jonathanmolla/bluetooth-headphones/firmware/README.md

# STM32 controller configuration

[Firmware.ioc](Firmware.ioc) captures the STM32CubeMX configuration for the **STM32U031C8T6** headphone controller.

## Explore the configuration

1. Open `Firmware.ioc` in STM32CubeMX.
2. Inspect the controller pin assignments and configured peripherals.
3. Cross-reference the [MCU and button schematic](../hardware/main/MCU_Buttons.kicad_sch) to follow the hardware connections.

## Related design files

- [Controller schematic preview](../docs/schematics/main/Bluetooth%20Headphones%20Project-MCU_and_Buttons.svg)
- [Main audio board project](../hardware/main/)
- [System architecture](../docs/design.md)
