jonathanmolla/bluetooth-headphones/docs/schematics/README.md

# Circuit diagrams

Browser-readable schematic exports from KiCad 10.0.3.

| Diagram | Circuit contents | Editable source |
| --- | --- | --- |
| [Main project hierarchy](main/Bluetooth%20Headphones%20Project.svg) | Audio and controller sheet organization | [Root schematic](../../hardware/main/Bluetooth%20Headphones%20Project.kicad_sch) |
| [Bluetooth and audio](main/Bluetooth%20Headphones%20Project-Bluetooth_and_Audio.svg) | BM83 module, coupling capacitors and headphone amplifier | [Audio schematic](../../hardware/main/Bluetooth_Audio.kicad_sch) |
| [MCU and buttons](main/Bluetooth%20Headphones%20Project-MCU_and_Buttons.svg) | STM32 controller and button connections | [Controller schematic](../../hardware/main/MCU_Buttons.kicad_sch) |
| [Charging and power](power/Charging%20and%20Power.svg) | USB input, battery charging and regulation | [Power schematic](../../hardware/power/Charging%20and%20Power.kicad_sch) |

Open or download an SVG to zoom into the circuit. [PCB layouts and project files](../../hardware/) are organized by board.
