jonathanmolla/bluetooth-headphones/hardware/power/README.md

# Charging and power board

This board contains the USB power input, MCP73833 battery-charging circuit, and TPS7A2030PDBVR 3.0 V regulator.

## Charging and power PCB

**Editable board layout:** [Charging and Power.kicad_pcb](Charging%20and%20Power.kicad_pcb)

**Open the complete KiCad project:** [Charging and Power.kicad_pro](Charging%20and%20Power.kicad_pro)

**View the layout in your browser:** [Charging and power PCB preview](../../docs/images/power-board.svg)

## Schematic and component list

| File | Contents |
| --- | --- |
| [Power schematic](Charging%20and%20Power.kicad_sch) | Charging, regulation, indicators and board connections |
| [Component list](bom.csv) | Schematic references, values, footprints and datasheet links |

[View the power schematic](../../docs/schematics/power/Charging%20and%20Power.svg) · [Open the main audio board](../main/)

## Library files

`MCP73833-AMI_UN.pretty/` and `TPS7A2030PDBVR.pretty/` contain the local charger and regulator CAD assets. Keep these folders and both library tables beside the project when downloading it.
