jonathanmolla/bluetooth-headphones/docs/references.md

# Component documentation and references

| Component or tool | Documentation |
| --- | --- |
| BM83 Bluetooth audio module | [Microchip product page](https://www.microchip.com/en-us/product/BM83) |
| TPA6130A2 headphone amplifier | [TI datasheet](https://www.ti.com/lit/ds/symlink/tpa6130a2.pdf) |
| STM32U031 controller | [ST datasheet](https://www.st.com/resource/en/datasheet/stm32u031r6.pdf) |
| TPS7A20 regulator | [TI documentation](https://www.ti.com/lit/gpn/TPS7A20) |
| MCP73833 charger | [Microchip datasheet](https://ww1.microchip.com/downloads/aemDocuments/documents/APID/ProductDocuments/DataSheets/MCP73833-4-Stand-Alone-Linear-Li-Ion-Li-Polymer-Charge-Management-Control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) |
| KiCad | [Tool documentation](https://docs.kicad.org/) |

## CAD and simulation assets

Project-local symbols and footprints accompany the native design files. Third-party CAD assets and standard library material retain their respective authorship and terms. Manufacturer documentation is accessible through the links above.

The LTspice library contains educational ideal-source and differential-gain models. Its [parameter definitions and analysis instructions](../simulation/README.md) document the analog-network representation used in this project.
