jonathanmolla/bluetooth-headphones/hardware/power/bom.csv

Reference | Value | Footprint | Datasheet | Source
C1 | 1uF | Capacitor_SMD:C_0805_2012Metric |  | KiCad schematic
C2 | 1uF | Capacitor_SMD:C_0805_2012Metric |  | KiCad schematic
C3 | 1uF | Capacitor_SMD:C_0805_2012Metric |  | KiCad schematic
C4 | 1uF | Capacitor_SMD:C_0805_2012Metric |  | KiCad schematic
D1 | LED Yellow | LED_SMD:LED_0805_2012Metric |  | KiCad schematic
D2 | LED Green | LED_SMD:LED_0805_2012Metric |  | KiCad schematic
D3 | LED Red | LED_SMD:LED_0805_2012Metric |  | KiCad schematic
J2 | Battery rail | Connector_JST:JST_PH_B2B-PH-K_1x02_P2.00mm_Vertical |  | KiCad schematic
J3 | USB-C 5V IN | Connector_USB:USB_C_Receptacle_GCT_USB4125-xx-x_6P_TopMnt_Horizontal |  | KiCad schematic
J6 | To Main PCB | Connector_JST:JST_PH_B3B-PH-K_1x03_P2.00mm_Vertical |  | KiCad schematic
R1 | 470 | Resistor_SMD:R_0805_2012Metric |  | KiCad schematic
R2 | 470 | Resistor_SMD:R_0805_2012Metric |  | KiCad schematic
R3 | 470 | Resistor_SMD:R_0805_2012Metric |  | KiCad schematic
R4 | 12.7k | Resistor_SMD:R_0603_1608Metric |  | KiCad schematic
R8 | 5.1k | Resistor_SMD:R_0805_2012Metric |  | KiCad schematic
R9 | 5.1k | Resistor_SMD:R_0805_2012Metric |  | KiCad schematic
TH1 | 10k NTC | Connector_Wire:SolderWire-0.1sqmm_1x02_P3.6mm_D0.4mm_OD1mm |  | KiCad schematic
U1 | TPS7A2030PDBVR | TPS7A2030PDBVR:SOT95P280X145-5N |  | KiCad schematic
U2 | MCP73833-AMI_UN | MCP73833-AMI_UN:SOP50P490X110-10N |  | KiCad schematic
