jonathanmolla/bluetooth-headphones/simulation/Headphones_Audio.asc

C_BYPASS: cap; 1µ
C_L: cap; 0.47µ
C_LREF: cap; 0.47µ
C_R: cap; 0.47µ
C_RREF: cap; 0.47µ
R_LEFT_DRIVER: res; 38
R_RIGHT_DRIVER: res; 38
U_AMP: TPA6130A2_AUDIO_APPROX
U_BM83: BM83_AUDIO_APPROX
V_BATTERY: voltage; {VBAT}
Named nets: 0, AMP_INML, AMP_INMR, HPLEFT, HPRIGHT, VBAT
Bluetooth headphones - stereo analog audio path
Simplified models only: BM83 DAC sources -> coupling -> amplifier -> resistive drivers
Educational approximation - see README.md for analysis instructions
.include audio_models.lib
.param VBAT=3.7 VBIAS=1.35 VSIG=50m FTEST=1k AVOL=1 RINPUT=37k
.ac dec 100 10 100k
Optional transient command (inactive): .tran 0 20m 0 1u
Bias 1.35 V and 50 mV signal are illustrative; 38 ohm loads approximate the drivers.
AVOL=1 is an ideal unity-gain setting; RINPUT=37k is a conservative input-resistance approximation.
Analysis scope: analog coupling-network response and ideal stereo voltage gain.
VBAT and supply bypassing identify the circuit supply reference.
.tran 5
