jonathanmolla/bluetooth-headphones/hardware/power/Charging and Power.kicad_pcb

## KiCad design hardware/power/Charging and Power.kicad_pcb (2026-11-12)

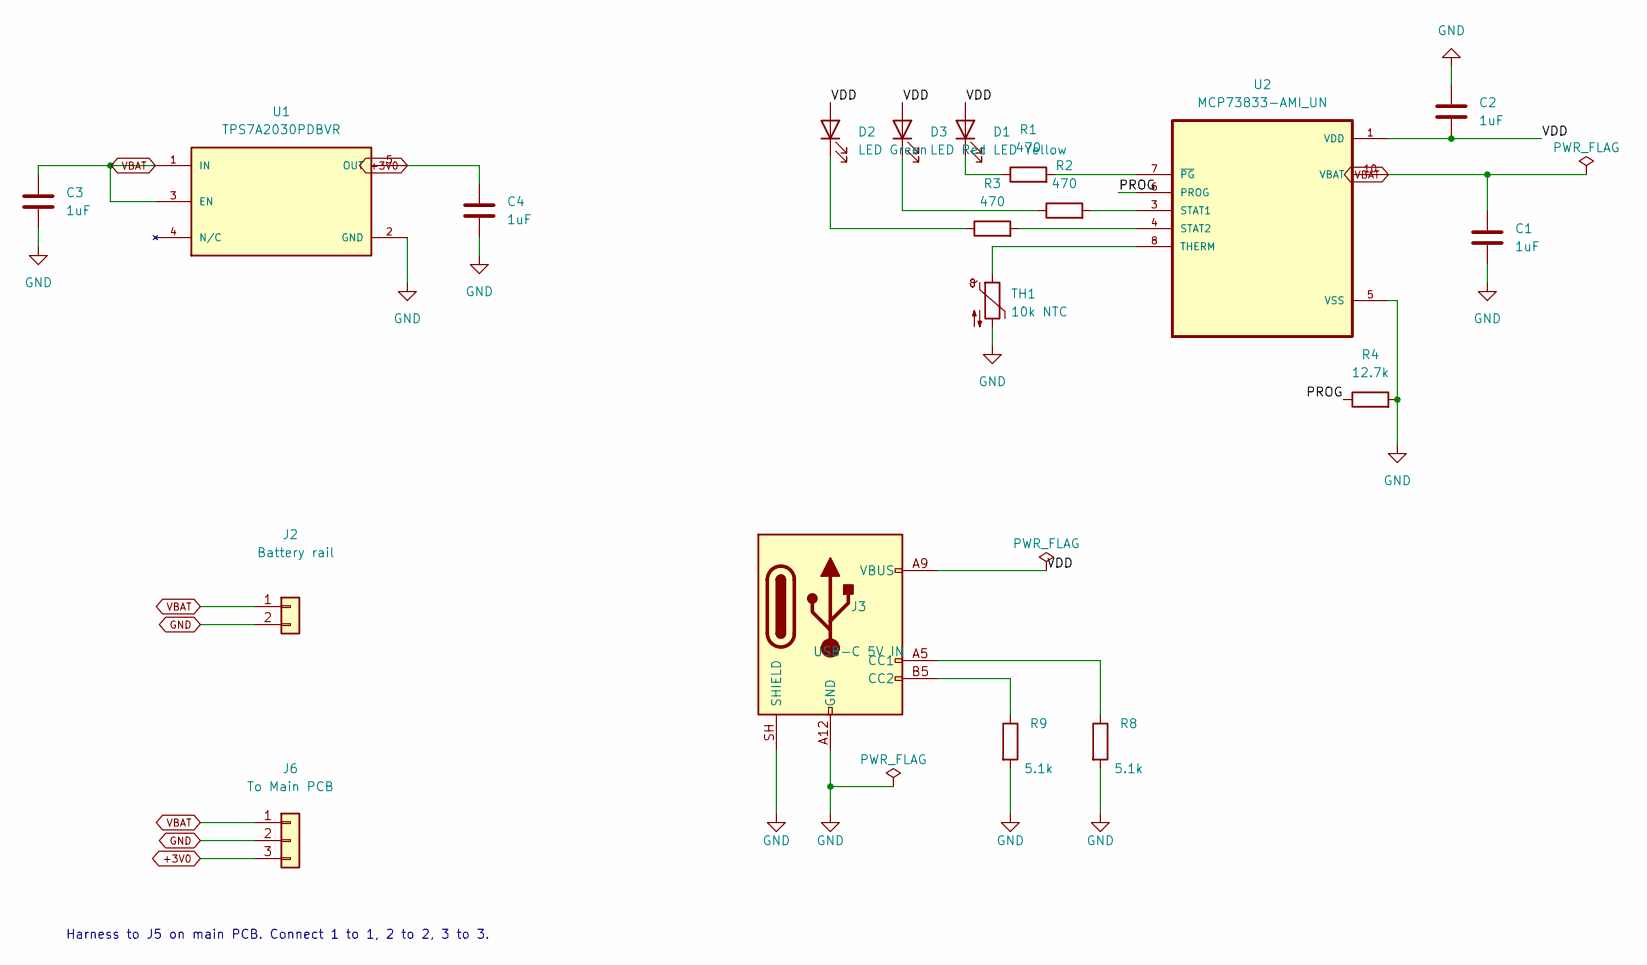
[picture p1: schematic Charging and Power.kicad_sch, Battery Charger and 3.0 V Regulator]

Parts:
C1, C2, C3, C4: 1uF; C_0805_2012Metric; MPN GRM219R71E105KA88D
D1: LED Yellow; LED_0805_2012Metric; MPN AP2012SYC
D2: LED Green; LED_0805_2012Metric; MPN AP2012SGC
D3: LED Red; LED_0805_2012Metric; MPN APT2012SURCK
J2: Battery rail; JST_PH_B2B-PH-K_1x02_P2.00mm_Vertical; MPN B2B-PH-K-S(LF)(SN)
J3: USB-C 5V IN; USB_C_Receptacle_GCT_USB4125-xx-x_6P_TopMnt_Horizontal; MPN USB4125-GF-A
J6: To Main PCB; JST_PH_B3B-PH-K_1x03_P2.00mm_Vertical; MPN B3B-PH-K-S(LF)(SN)
R1, R2, R3: 470; R_0805_2012Metric; MPN ERJ-6ENF4700V
R4: 12.7k; R_0603_1608Metric; MPN RC0603FR-0712K7L
R8, R9: 5.1k; R_0805_2012Metric; MPN RC0805FR-075K1L
TH1: 10k NTC; SolderWire-0.1sqmm_1x02_P3.6mm_D0.4mm_OD1mm; MPN B57861S0103F040
U1: TPS7A2030PDBVR; SOT95P280X145-5N; PARTREV H
U2: MCP73833-AMI_UN; SOP50P490X110-10N

Connections:
+3V0: C4.1, J6.3, U1.5 (OUT)
/PROG: R4.1, U2.6 (PROG)
GND: C1.2, C2.1, C3.2, C4.2, J2.2, J3.A12 (GND), J3.B12 (GND), J3.SH (SHIELD), J6.2, R4.2, R8.2, R9.2, TH1.2, U1.2 (GND), U2.5 (VSS)
unnamed: D1.1 (K), R1.1
unnamed: D2.1 (K), R3.1
unnamed: D3.1 (K), R2.1
unnamed: J3.A5 (CC1), R8.1
unnamed: J3.B5 (CC2), R9.1
unnamed: R2.2, U2.3 (STAT1)
unnamed: R3.2, U2.4 (STAT2)
unnamed: TH1.1, U2.8 (THERM)
unnamed: R1.2, U2.7 (~PG)
VBAT: C1.1, C3.1, J2.1, J6.1, U1.1 (IN), U1.3 (EN), U2.9 (VBAT), U2.10 (VBAT)
VDD: C2.2, D1.2 (A), D2.2 (A), D3.2 (A), J3.A9 (VBUS), J3.B9 (VBUS), U2.1 (VDD), U2.2 (VDD)

Notes on the sheet:
Harness to J5 on main PCB. Connect 1 to 1, 2 to 2, 3 to 3.

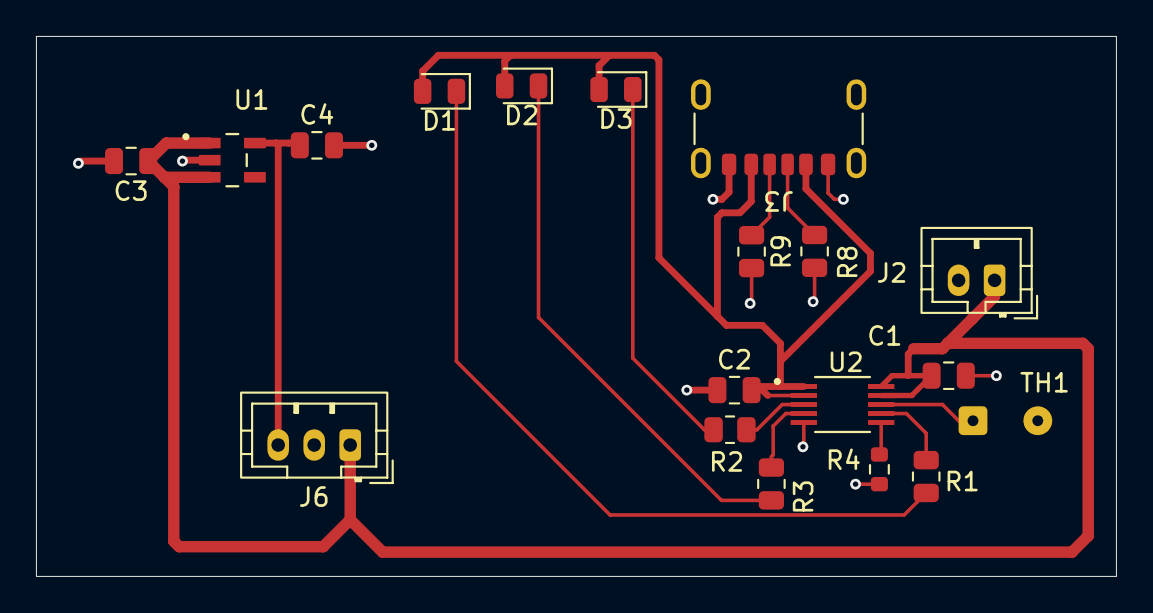
[picture p2: board Charging and Power.kicad_pcb from above]

Board: 2 copper layers, 60.0 x 30.0 mm, 19 parts (0 on the bottom side), 14 nets.
