jonathanmolla/bluetooth-headphones/hardware/main/Bluetooth Headphones Project.kicad_pcb

## KiCad design hardware/main/Bluetooth Headphones Project.kicad_pcb (2026-11-12)

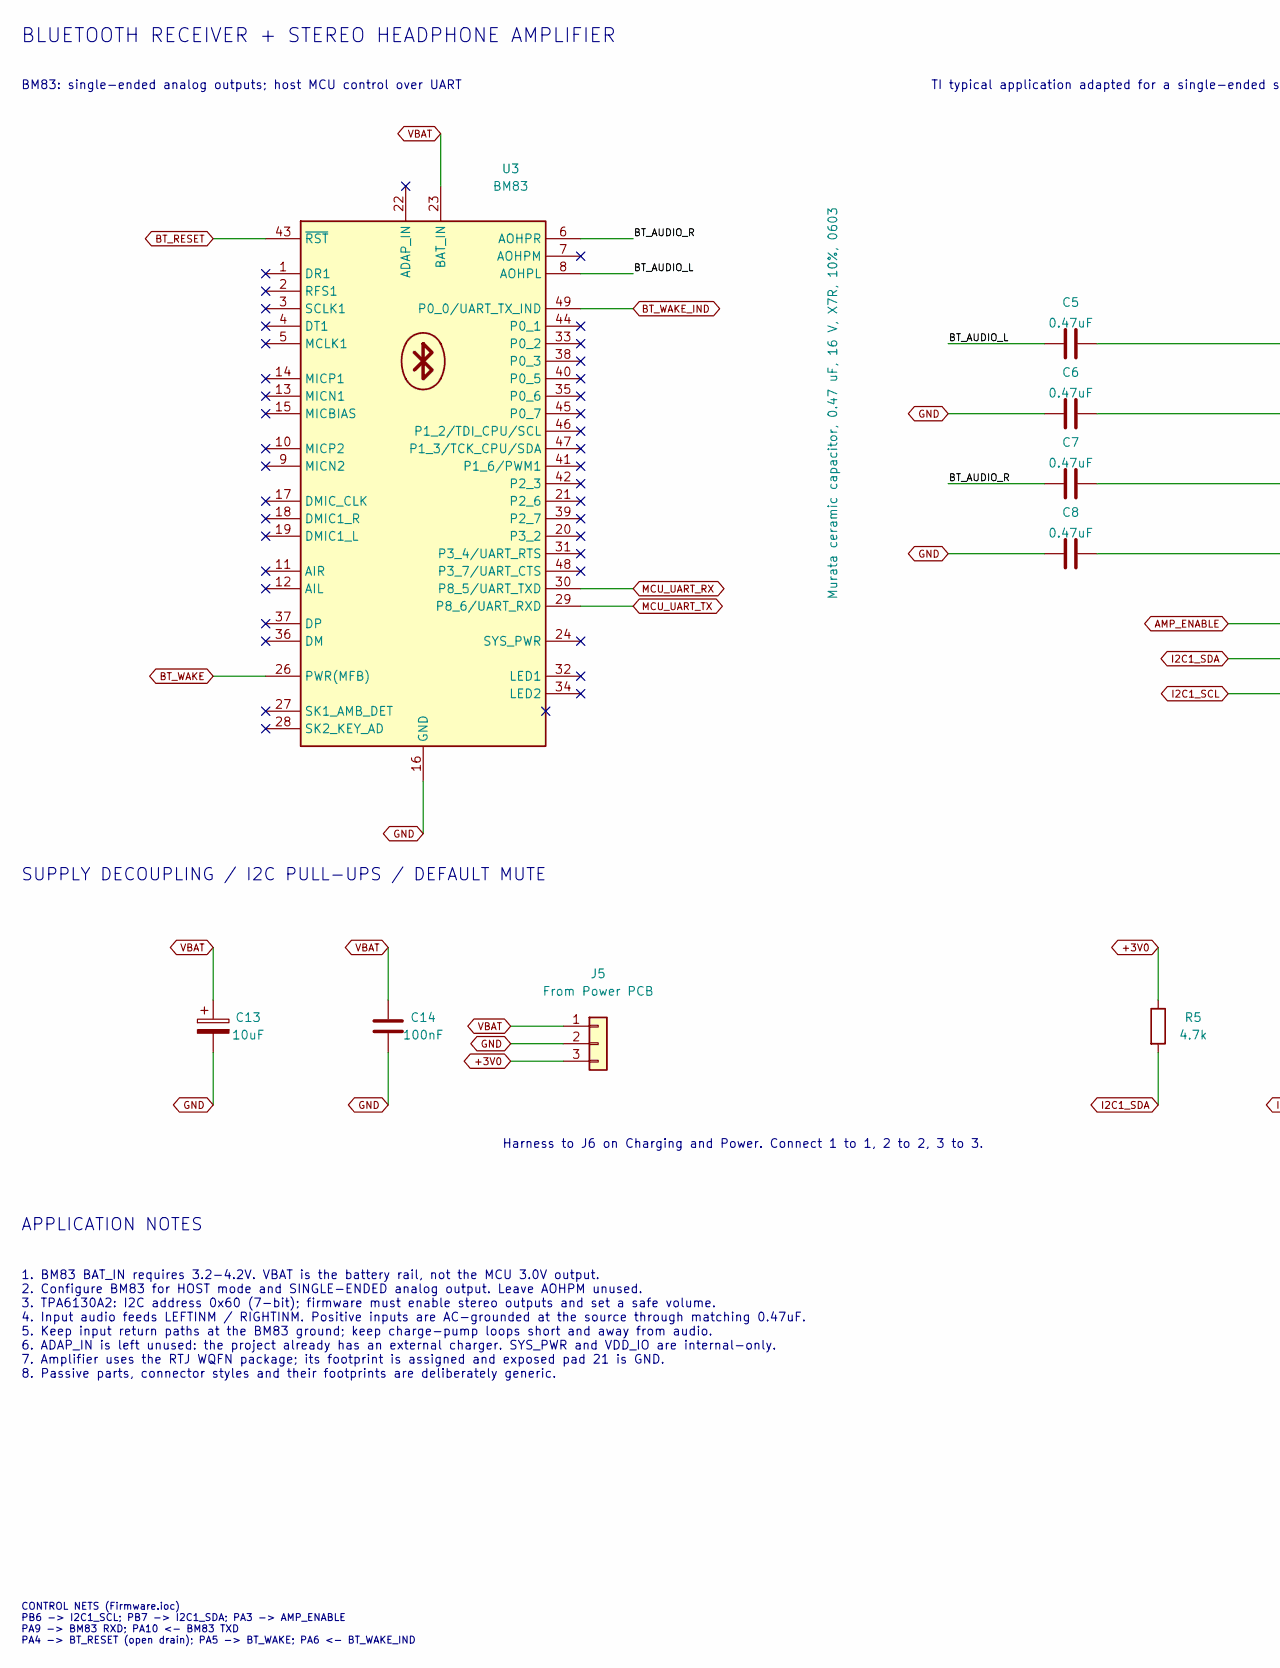
[picture p3: schematic Bluetooth_Audio.kicad_sch, BM83 and TPA6130A2 Typical Application, part in row 1, column 1]

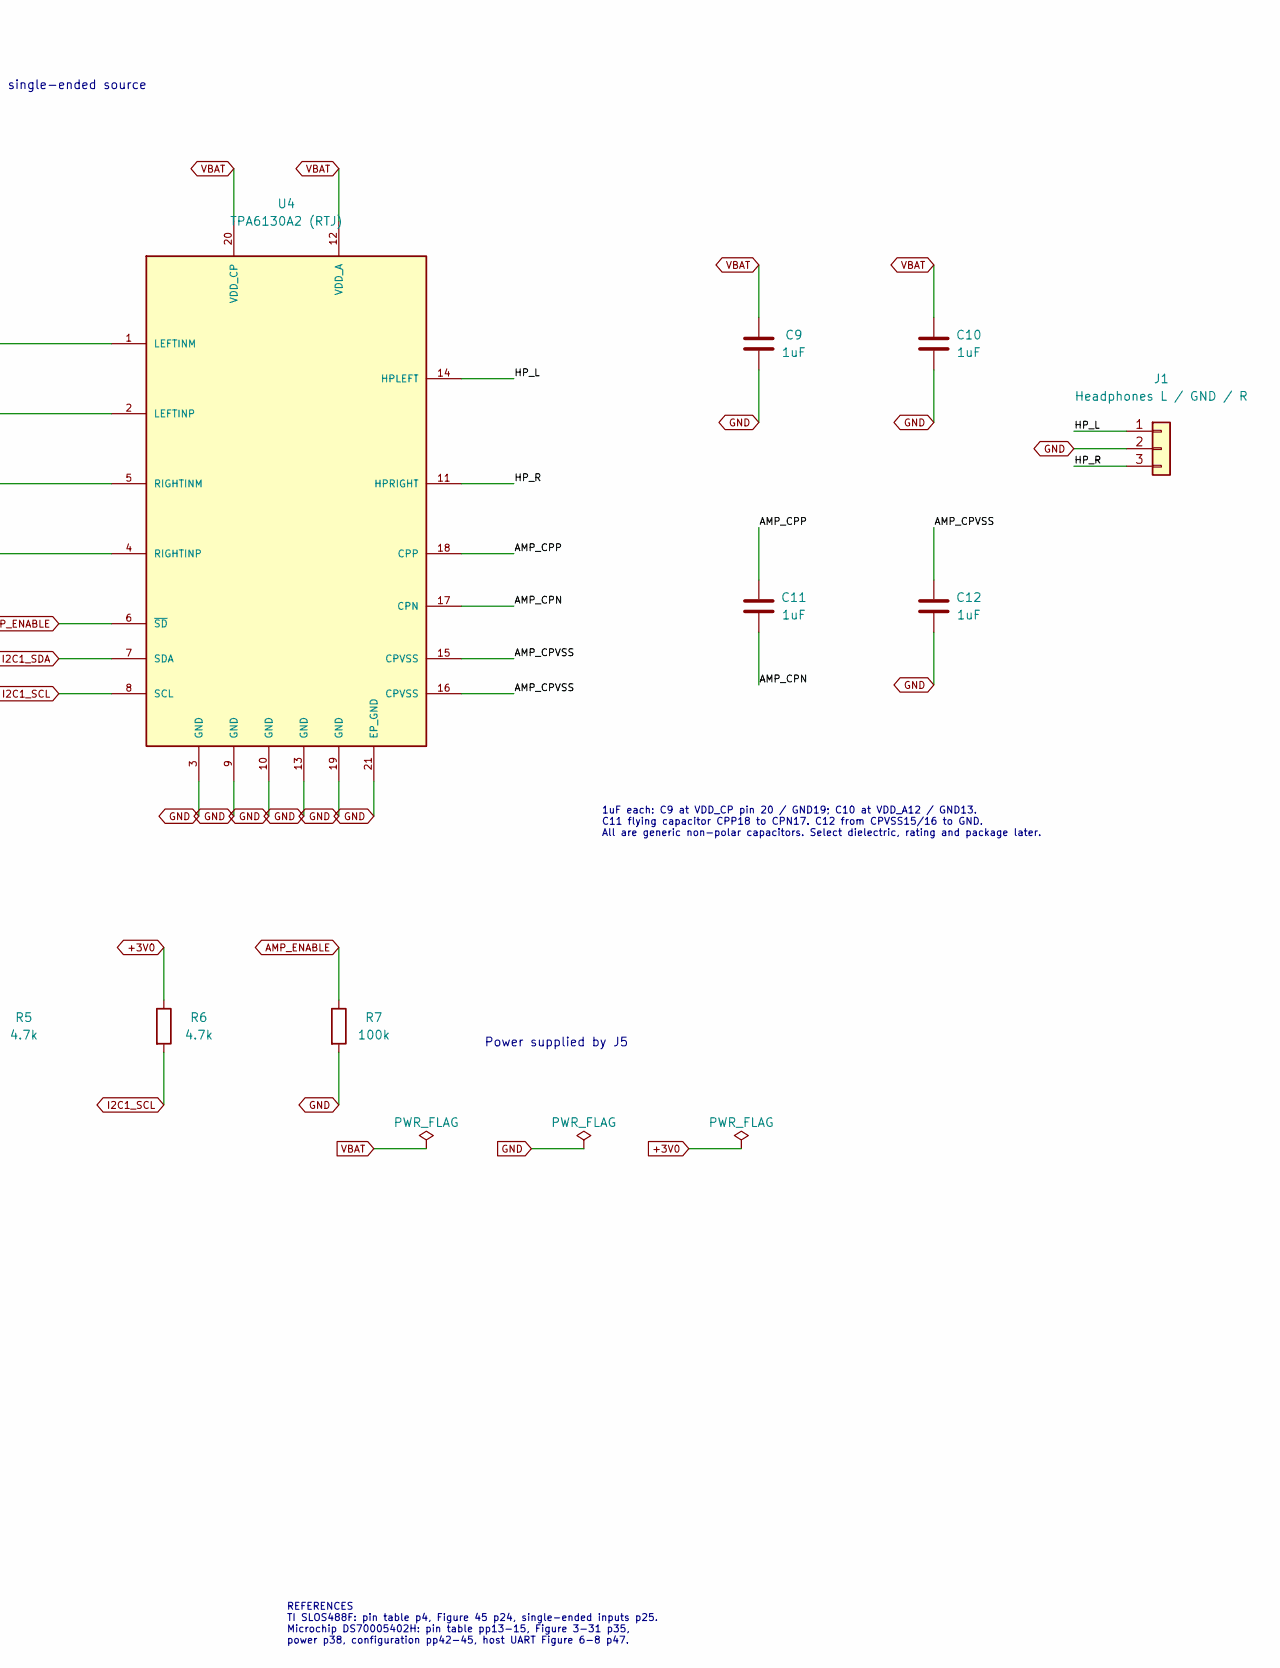
[picture p4: schematic Bluetooth_Audio.kicad_sch, BM83 and TPA6130A2 Typical Application, part in row 1, column 2]

Parts:
C5, C6, C7, C8: 0.47uF; C_0603_1608Metric; MPN GRM188R71C474KA88D
C9, C10, C11, C12: 1uF; C_0805_2012Metric; MPN GRM219R71E105KA88D
C13: 10uF; CP_Elec_4x5.8; MPN EEE-FN1C100R
C14: 100nF; C_0603_1608Metric; MPN GRM188R72A104KA35J
J1: Headphones L / GND / R; PinHeader_1x03_P2.54mm_Vertical; MPN TSW-103-07-G-S
J5: From Power PCB; JST_PH_B3B-PH-K_1x03_P2.00mm_Vertical; MPN B3B-PH-K-S(LF)(SN)
R5, R6: 4.7k; R_0603_1608Metric; MPN RC0603FR-074K7L
R7: 100k; R_0603_1608Metric; MPN RC0603FR-07100KL
U3: BM83; Microchip_BM83
U4: TPA6130A2 (RTJ); TPA6130A2_RTJ_4x4mm_P0.5mm_EP2.7x2.7mm

Connections:
+3V0: J5.3, R5.1, R6.1; also elsewhere on the board
/Bluetooth_and_Audio/AMP_CPN: C11.2, U4.17 (CPN)
/Bluetooth_and_Audio/AMP_CPP: C11.1, U4.18 (CPP)
/Bluetooth_and_Audio/AMP_CPVSS: C12.1, U4.15 (CPVSS), U4.16 (CPVSS)
/Bluetooth_and_Audio/BT_AUDIO_L: C5.2, U3.8 (AOHPL)
/Bluetooth_and_Audio/BT_AUDIO_R: C7.2, U3.6 (AOHPR)
/Bluetooth_and_Audio/HP_L: J1.1, U4.14 (HPLEFT)
/Bluetooth_and_Audio/HP_R: J1.3, U4.11 (HPRIGHT)
AMP_ENABLE: R7.1, U4.6 (~SD); also elsewhere on the board
BT_RESET: U3.43 (~RST); also elsewhere on the board
BT_WAKE: U3.26 (PWR(MFB)); also elsewhere on the board
BT_WAKE_IND: U3.49 (P0_0/UART_TX_IND); also elsewhere on the board
GND: C6.2, C8.2, C9.2, C10.2, C12.2, C13.2, C14.2, J1.2, J5.2, R7.2, U3.16 (GND), U3.50 (GND), U3.56 (GND), U3.57 (GND), U4.3 (GND), U4.9 (GND), U4.10 (GND), U4.13 (GND), U4.19 (GND), U4.21 (EP_GND); also elsewhere on the board
I2C1_SCL: R6.2, U4.8 (SCL); also elsewhere on the board
I2C1_SDA: R5.2, U4.7 (SDA); also elsewhere on the board
MCU_UART_RX: U3.30 (P8_5/UART_TXD); also elsewhere on the board
MCU_UART_TX: U3.29 (P8_6/UART_RXD); also elsewhere on the board
unnamed: C5.1, U4.1 (LEFTINM)
unnamed: C6.1, U4.2 (LEFTINP)
unnamed: C7.1, U4.5 (RIGHTINM)
unnamed: C8.1, U4.4 (RIGHTINP)
VBAT: C9.1, C10.1, C13.1, C14.1, J5.1, U3.23 (BAT_IN), U4.12 (VDD_A), U4.20 (VDD_CP); also elsewhere on the board

Notes on the sheet:
SUPPLY DECOUPLING / I2C PULL-UPS / DEFAULT MUTE
REFERENCES TI SLOS488F: pin table p4, Figure 45 p24, single-ended inputs p25. Microchip DS70005402H: pin table pp13-15, Figure 3-31 p35, power p38, configuration pp42-45, host UART Figure 6-8 p47.
1uF each: C9 at VDD_CP pin 20 / GND19; C10 at VDD_A12 / GND13. C11 flying capacitor CPP18 to CPN17. C12 from CPVSS15/16 to GND. All are generic non-polar capacitors. Select dielectric, rating and package later.
CONTROL NETS (Firmware.ioc) PB6 -> I2C1_SCL; PB7 -> I2C1_SDA; PA3 -> AMP_ENABLE PA9 -> BM83 RXD; PA10 <- BM83 TXD PA4 -> BT_RESET (open drain); PA5 -> BT_WAKE; PA6 <- BT_WAKE_IND
1. BM83 BAT_IN requires 3.2-4.2V. VBAT is the battery rail, not the MCU 3.0V output. 2. Configure BM83 for HOST mode and SINGLE-ENDED analog output. Leave AOHPM unused. 3. TPA6130A2: I2C address 0x60 (7-bit); firmware must enable stereo outputs and set a safe volume. 4. Input audio feeds LEFTINM / 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
Harness to J6 on Charging and Power. Connect 1 to 1, 2 to 2, 3 to 3.
APPLICATION NOTES
TI typical application adapted for a single-ended source
BLUETOOTH RECEIVER + STEREO HEADPHONE AMPLIFIER
BM83: single-ended analog outputs; host MCU control over UART
Power supplied by J5

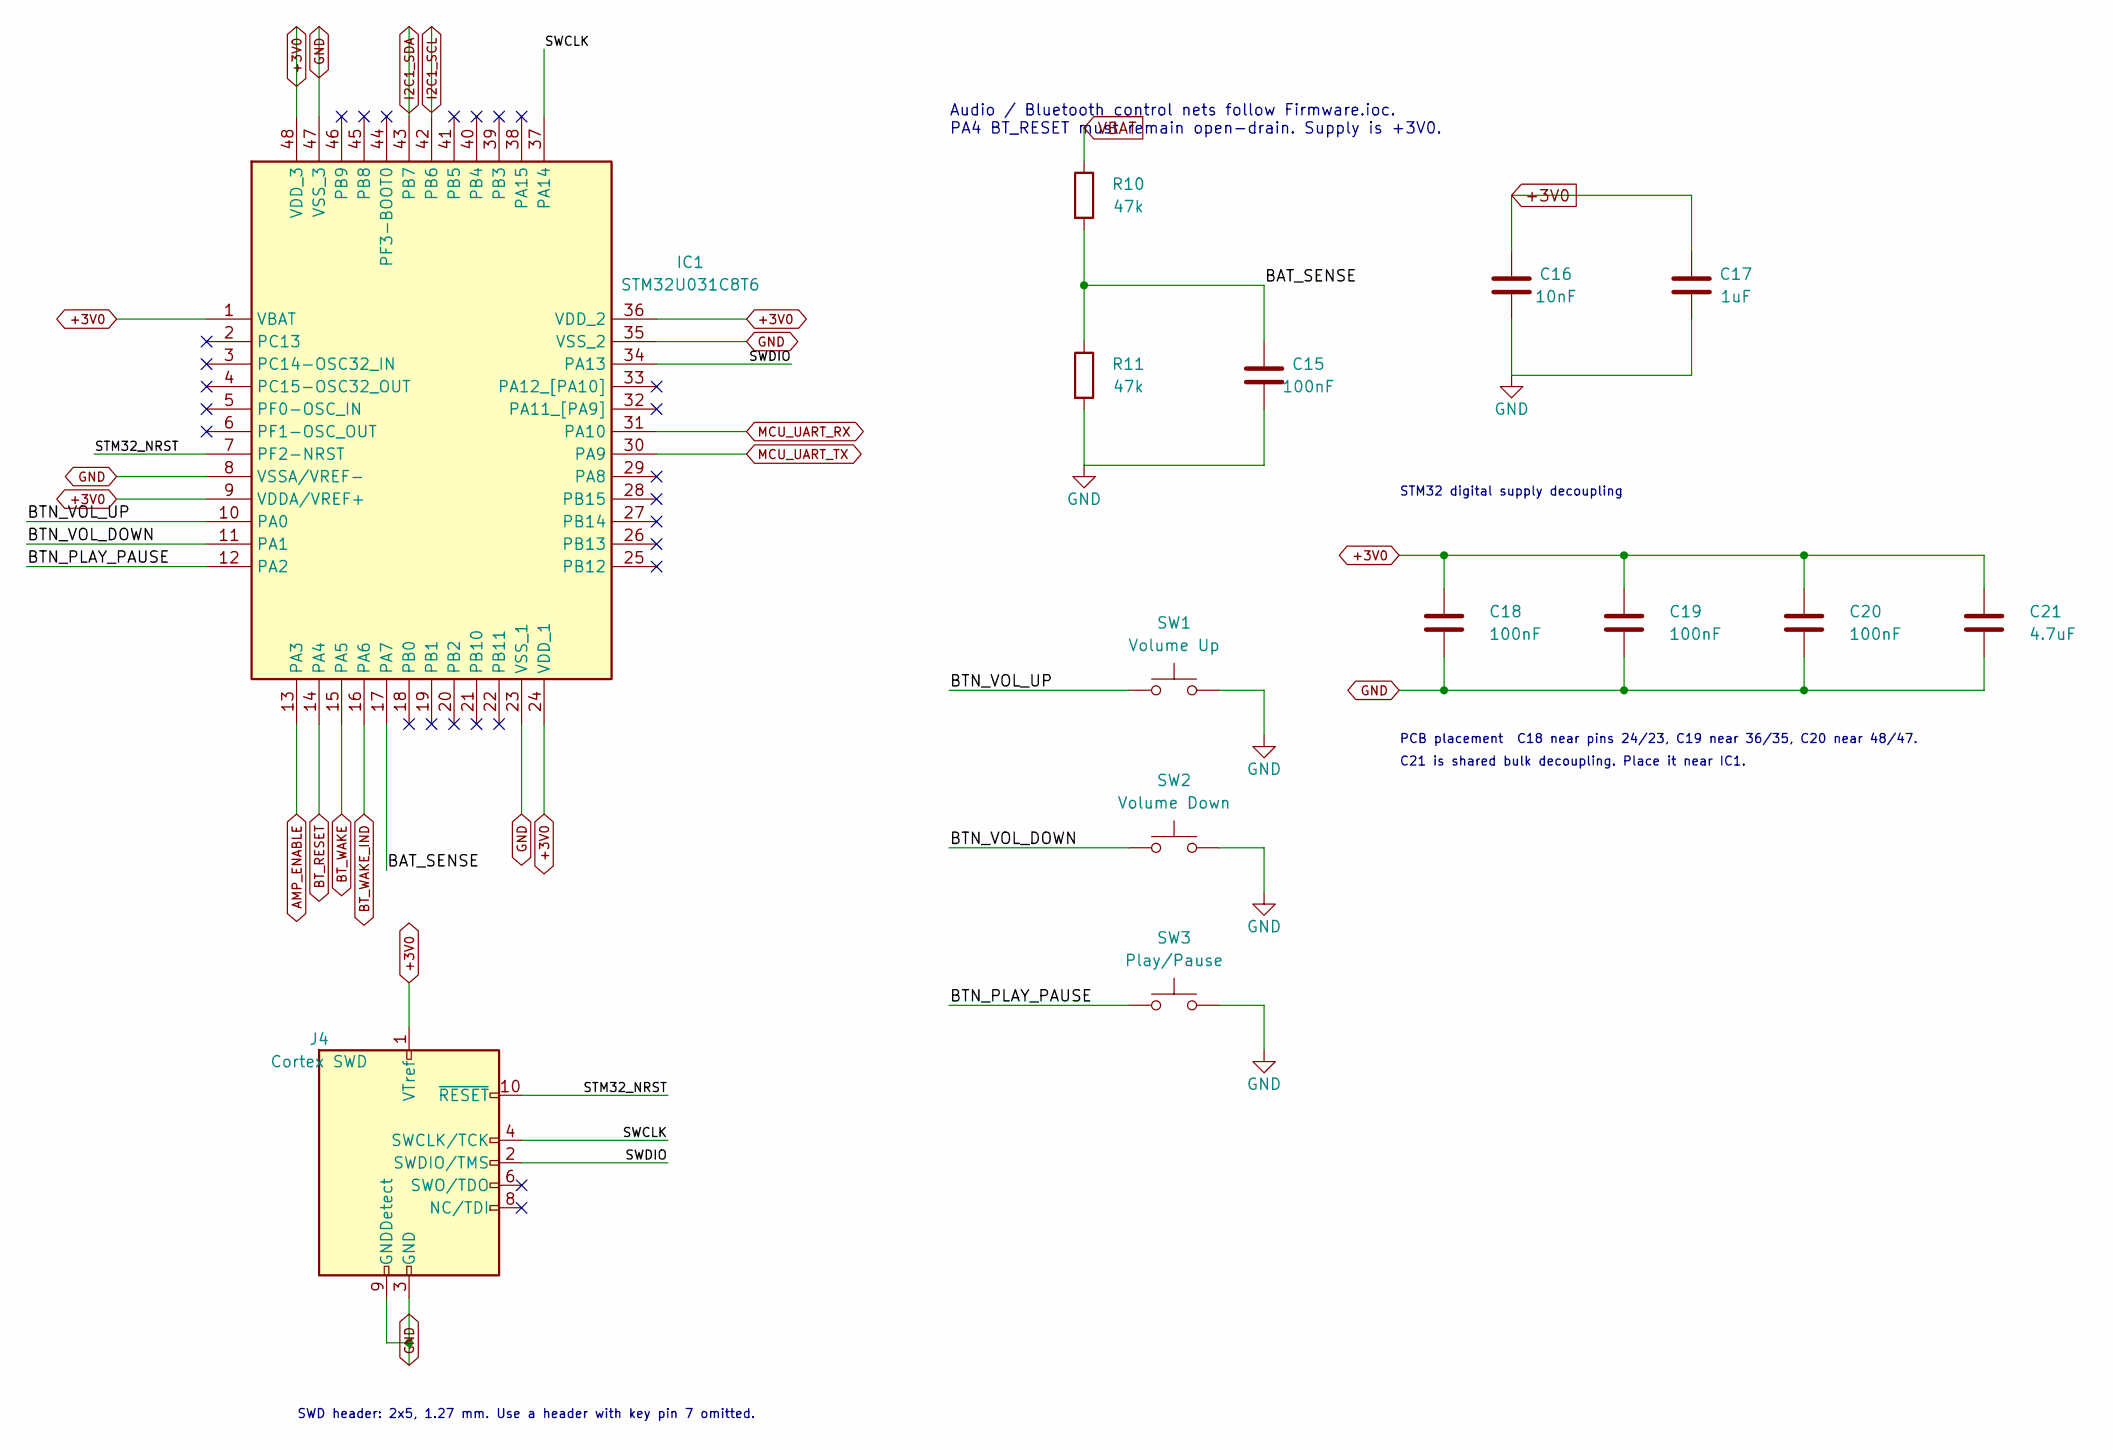
[picture p5: schematic MCU_Buttons.kicad_sch]

Parts:
C15: 100nF; C_0603_1608Metric; MPN GRM188R72A104KA35J
C16: 10nF; C_0603_1608Metric; MPN CC0603KRX7R9BB103
C17: 1uF; C_0805_2012Metric; MPN GRM219R71E105KA88D
C18, C19, C20: 100nF; C_0603_1608Metric
C21: 4.7uF; C_0805_2012Metric
IC1: STM32U031C8T6; QFP50P900X900X160-48N; Manufacturer_Part_Number STM32U031C8T6; Mouser Part Number 511-STM32U031C8T6
J4: Cortex SWD; PinHeader_2x05_P1.27mm_Vertical
R10, R11: 47k; R_0603_1608Metric; MPN RC0603FR-0747KL
SW1: Volume Up; SW_TH_Tactile_Omron_B3F-100x; MPN B3F-1002-G
SW2: Volume Down; SW_TH_Tactile_Omron_B3F-100x; MPN B3F-1002-G
SW3: Play/Pause; SW_TH_Tactile_Omron_B3F-100x; MPN B3F-1002-G

Connections:
+3V0: C16.1, C17.1, C18.1, C19.1, C20.1, C21.1, IC1.1 (VBAT), IC1.9 (VDDA/VREF+), IC1.24 (VDD_1), IC1.36 (VDD_2), IC1.48 (VDD_3), J4.1 (VTref); also elsewhere on the board
/MCU_and_Buttons/BAT_SENSE: C15.1, IC1.17 (PA7), R10.2, R11.1
/MCU_and_Buttons/BTN_PLAY_PAUSE: IC1.12 (PA2), SW3.1
/MCU_and_Buttons/BTN_VOL_DOWN: IC1.11 (PA1), SW2.1
/MCU_and_Buttons/BTN_VOL_UP: IC1.10 (PA0), SW1.1
/MCU_and_Buttons/STM32_NRST: IC1.7 (PF2-NRST), J4.10 (~RESET)
/MCU_and_Buttons/SWCLK: IC1.37 (PA14), J4.4 (SWCLK/TCK)
/MCU_and_Buttons/SWDIO: IC1.34 (PA13), J4.2 (SWDIO/TMS)
AMP_ENABLE: IC1.13 (PA3); also elsewhere on the board
BT_RESET: IC1.14 (PA4); also elsewhere on the board
BT_WAKE: IC1.15 (PA5); also elsewhere on the board
BT_WAKE_IND: IC1.16 (PA6); also elsewhere on the board
GND: C15.2, C16.2, C17.2, C18.2, C19.2, C20.2, C21.2, IC1.8 (VSSA/VREF-), IC1.23 (VSS_1), IC1.35 (VSS_2), IC1.47 (VSS_3), J4.3 (GND), J4.5 (GND), J4.9 (GNDDetect), R11.2, SW1.2, SW2.2, SW3.2; also elsewhere on the board
I2C1_SCL: IC1.42 (PB6); also elsewhere on the board
I2C1_SDA: IC1.43 (PB7); also elsewhere on the board
MCU_UART_RX: IC1.31 (PA10); also elsewhere on the board
MCU_UART_TX: IC1.30 (PA9); also elsewhere on the board
VBAT: R10.1; also elsewhere on the board

Notes on the sheet:
C21 is shared bulk decoupling. Place it near IC1.
Audio / Bluetooth control nets follow Firmware.ioc. PA4 BT_RESET must remain open-drain. Supply is +3V0.
STM32 digital supply decoupling
SWD header: 2x5, 1.27 mm. Use a header with key pin 7 omitted.
PCB placement C18 near pins 24/23, C19 near 36/35, C20 near 48/47.

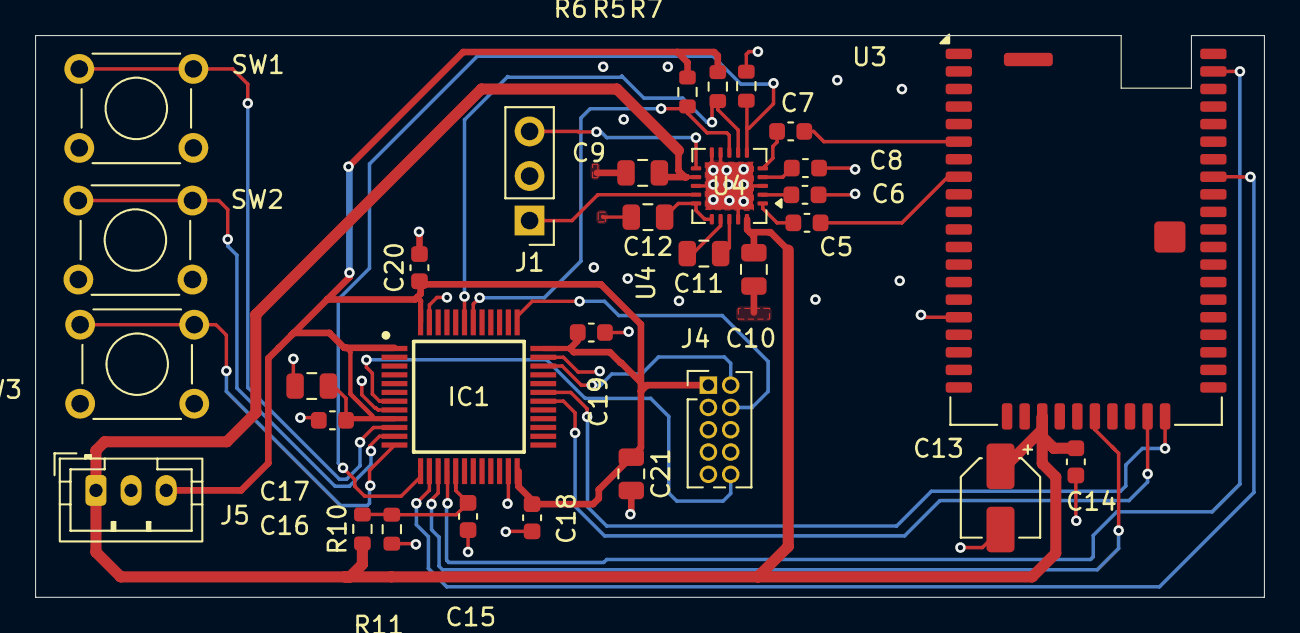
[picture p6: board Bluetooth Headphones Project.kicad_pcb from above]

Board: 4 copper layers, 70.0 x 32.0 mm, 31 parts (0 on the bottom side), 29 nets.
