jonathanmolla/bluetooth-headphones/firmware/Firmware.ioc

Mcu.UserName=STM32U031C8Tx
PA0.GPIO_Label=BTN_VOL_UP
PA0.Signal=GPIO_Input
PA1.GPIO_Label=BTN_VOL_DOWN
PA1.Signal=GPIO_Input
PA10.Signal=USART1_RX
PA2.GPIO_Label=BTN_PLAY_PAUSE
PA2.Signal=GPIO_Input
PA3.GPIO_Label=AMP_ENABLE
PA3.Signal=GPIO_Output
PA4.GPIO_Label=BT_RESET
PA4.Signal=GPIO_Output
PA5.GPIO_Label=BT_WAKE
PA5.Signal=GPIO_Output
PA6.GPIO_Label=BT_WAKE_IND
PA6.Signal=GPIO_Input
PA7.GPIO_Label=BAT_SENSE
PA7.Signal=ADC1_IN14
PA9.Signal=USART1_TX
PB6.Signal=I2C1_SCL
PB7.Signal=I2C1_SDA
