jonathanmolla/bluetooth-headphones/(commit log)

2026-11-12 Add main audio PCB and hierarchical schematics
    [Bluetooth Headphones Project.kicad_pcb, Bluetooth Headphones Project.kicad_sch, Bluetooth_Audio.kicad_sch, MCU_Buttons.kicad_sch, bom.csv]
2026-11-12 Add charging and regulation PCB source
    [Charging and Power.kicad_pcb, Charging and Power.kicad_sch, bom.csv]
2026-11-12 Add project-local audio footprints
2026-11-12 Add project-local STM32 footprint
2026-11-12 Add charger symbol, footprint and 3D model
2026-11-12 Add regulator symbol and footprint
2026-11-12 Add STM32 configuration and firmware roadmap
2026-11-12 Record schematic and PCB validation findings
2026-11-12 Add browser-readable PCB layout previews
2026-11-12 Add schematic preview navigation
2026-11-12 Add audio and controller schematic previews
2026-11-12 Add charging and power schematic preview
2026-11-12 Preserve CAD line endings and correct file detection
2026-11-12 Enlarge PCB previews for portfolio review
2026-11-12 Add board navigation to the hardware folder
2026-11-12 Identify the main audio PCB and its design files
    [bom.csv]
2026-11-12 Identify the charging PCB and its design files
    [bom.csv]
2026-11-12 Present STM32 pin and peripheral configuration
2026-11-12 Link PCB previews directly to editable board files
2026-11-12 Organize schematic previews by circuit function
